TheBadZhang/LED-LIGHT-USB/readme.md

# 陶瓷灯丝 LED

很简单的电路设计，没有什么特别值得说的

简而言之就是USB供电，通过一个限流保护开关，然后通过一个LED驱动芯片驱动4串LED，通过一个LED触摸控制芯片控制灯的亮度

焊接的时候需要注意LED的正负，我买的陶瓷灯丝LED上是有孔的一端为正，对应圆角矩形的一端为正，椭圆矩形的一端为负
